gilblankenship/CompanionRobotWeaver/images/blankenship.jpg

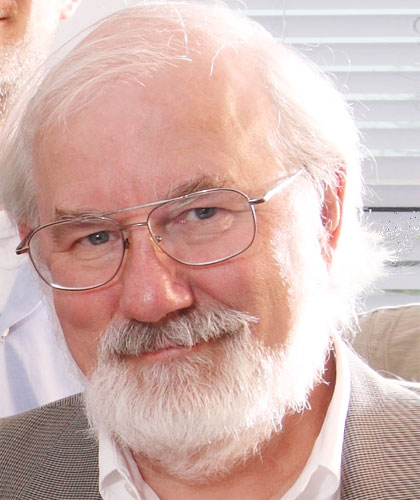
images/blankenship.jpg
