gilblankenship/CompanionRobotWeaver/README.md

Autonomous Robotic Companion

To run first call ./ngrok http 5000
then update alexa endpoint to new URL
run python3 main.py

If you force quit main killall python3 processes
