gilblankenship/CompanionRobotWeaver/Confusion Matrix.png

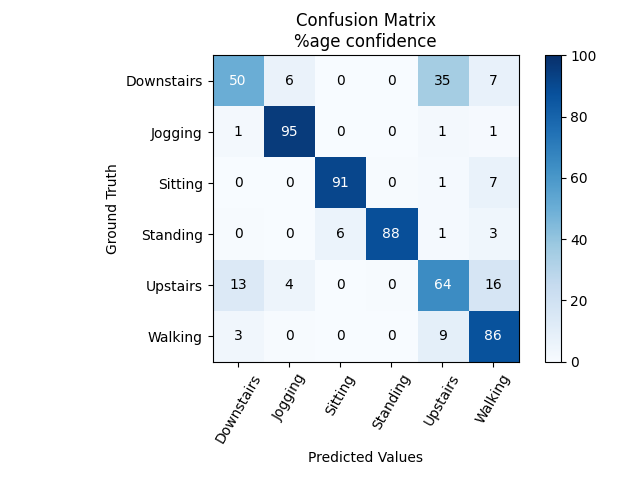
Confusion Matrix.png
