gilblankenship/CompanionRobotWeaver/image.jpg

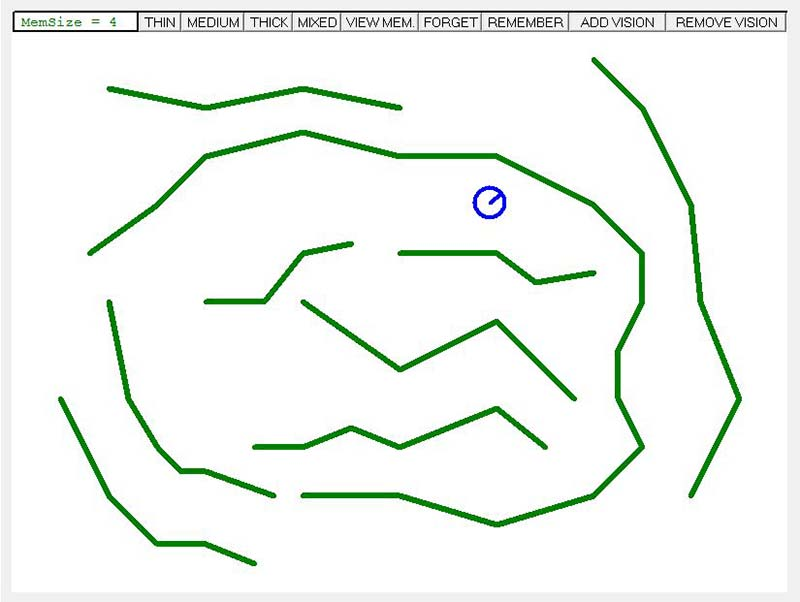
image.jpg
