gilblankenship/CompanionRobotWeaver/images/biden.jpg

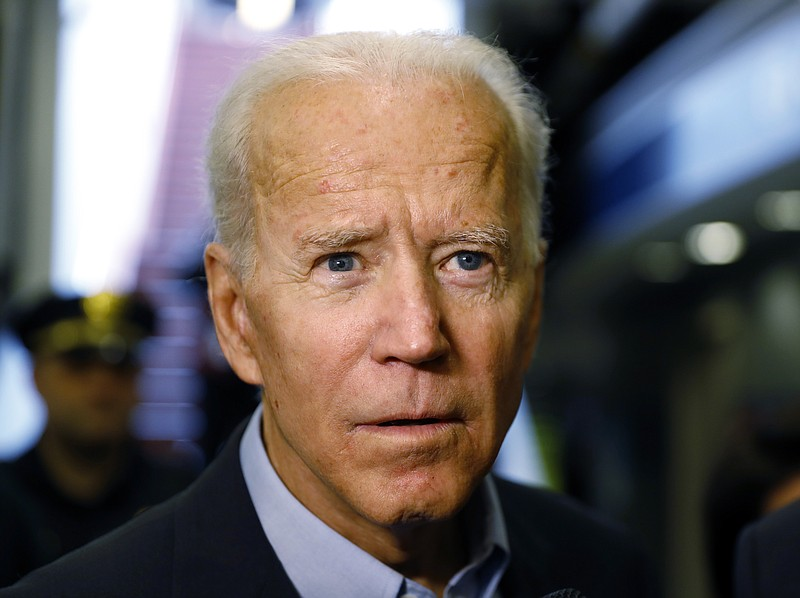
images/biden.jpg
