gilblankenship/CompanionRobotWeaver/images/hizoune.jpg

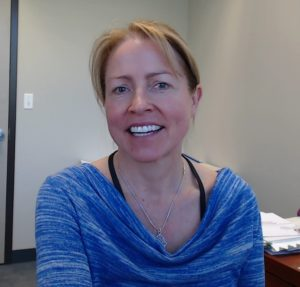
images/hizoune.jpg
