gilblankenship/CompanionRobotWeaver/images/rmacko.jpg

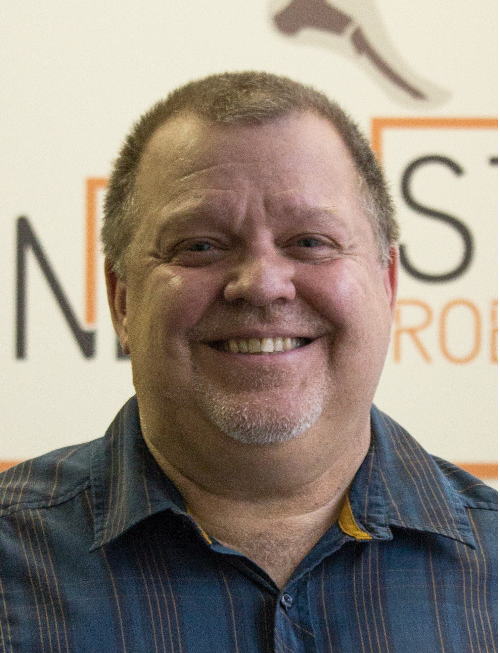
images/rmacko.jpg
