gilblankenship/CompanionRobotWeaver/ardControlerV2/SerialDataComm.ino

/*
Based on  http://www.arduino.cc/en/Tutorial/SerialCallResponseASCII
*/

int firstSensor = 0;    // first analog sensor
int secondSensor = 0;   // second analog sensor
int thirdSensor = 0;    // digital sensor
int inByte = 0;         // incoming serial byte
long randNumber;

void setup() {
  randomSeed(analogRead(0)); // Generate a random seed
  // start serial port at 9600 bps and wait for port to open:
  Serial.begin(9600);
  while (!Serial) {
    ; // wait for serial port to connect. Needed for native USB port only
  }

  pinMode(2, INPUT);   // digital sensor is on digital pin 2
  establishContact();  // send a byte to establish contact until receiver responds
}

void loop() {
  // if we get a valid byte, read analog ins:
  if (Serial.available() > 0) {
    // get incoming byte:
    inByte = Serial.read();
    // read first analog input:
    firstSensor =  random(300); //analogRead(A0);
    // read second analog input:
    randNumber=random(300);
    secondSensor =  randNumber; //analogRead(A1);
    // read switch, map it to 0 or 255
    thirdSensor = map(digitalRead(2), 0, 1, 0, 255);
    // send sensor values:
    Serial.println(firstSensor);
    Serial.print(",");
    Serial.print(secondSensor);
    Serial.print(",");
    Serial.println(thirdSensor);
  }
}

void establishContact() {
  while (Serial.available() <= 0) {
    Serial.println("0,0,0");   // send an initial string
    delay(300);
  }
}
