gilblankenship/CompanionRobotWeaver/AutoregressiveTransformerModel.py

import tensorflow as tf

class AutoregressiveTransformerModel(tf.keras.Model):
    def __init__(self, vocab_size, embedding_dim, hidden_dim, num_heads, key_dim):
        super(AutoregressiveTransformerModel, self).__init__()
        self.embedding = tf.keras.layers.Embedding(vocab_size, embedding_dim)
        self.attention = tf.keras.layers.MultiHeadAttention(num_heads=num_heads, 
                                                            key_dim=key_dim)
        self.dense = tf.keras.layers.Dense(vocab_size)

    def call(self, inputs):
        x = self.embedding(inputs)
        x = self.attention(x, x, x)
        x = self.dense(x)
        return x
import tensorflow as tf

def main():
    # Create the model
    vocab_size = 10000
    embedding_dim = 128
    hidden_dim = 256
    num_heads = 8
    key_dim=10
    model = AutoregressiveTransformerModel(vocab_size, embedding_dim, hidden_dim, num_heads, key_dim)

    # Load the model weights
    model.load_weights("model.h5")

    # Generate text
    start_token = tf.constant([1])
    generated_text = tf.zeros([1, 100])
    for _ in range(100):
        next_token_predictions = model(generated_text)
        next_token = tf.argmax(next_token_predictions, axis=-1)
        generated_text = tf.concat([generated_text, next_token], axis=-1)

    print(generated_text)

if __name__ == "__main__":
    main()
