gilblankenship/CompanionRobotWeaver/SearchRegionXavier.py

```python
import cv2
import numpy as np
import math
import time
import csv
import serial

# initialize the camera
cap = cv2.VideoCapture(0)

# initialize the facial recognition model
face_cascade = cv2.CascadeClassifier('haarcascade_frontalface_default.xml')

# initialize the GPS
gps = gps.GPS()

# initialize the two driven wheels
left_wheel = Motor(17)
right_wheel = Motor(27)

# set the speed of the two driven wheels
left_wheel.set_speed(50)
right_wheel.set_speed(50)

# start the loop
while True:

    # get a frame from the camera
    ret, frame = cap.read()

    # convert the frame to grayscale
    gray = cv2.cvtColor(frame, cv2.COLOR_BGR2GRAY)

    # find the faces in the frame
    faces = face_cascade.detectMultiScale(gray, 1.3, 5)

    # for each face in the frame
    for (x, y, w, h) in faces:

        # draw a rectangle around the face
        cv2.rectangle(frame, (x, y), (x + w, y + h), (0, 255, 0), 2)

        # crop the face out of the frame
        face_roi = frame[y:y + h, x:x + w]

        # recognize the face
        face_id = recognize_face(face_roi)

        # if the face is recognized
        if face_id is not None:

            # print the name of the person
            print('The person in the frame is {}'.format(face_id))

            # get the location of the person
            (lat, lon) = gps.get_location()

            # print the location of the person
            print('The person is at {} {}'.format(lat, lon))

            # stop the robot
            left_wheel.stop()
            right_wheel.stop()

            # break out of the loop
            break

    # show the frame
    cv2.imshow('Frame', frame)

    # wait for a key press
    key = cv2.waitKey(1)

    # if the key is 'q', quit the program
    if key == ord('q'):
        break

# release the camera
cap.release()

# close all windows
cv2.destroyAllWindows()
```

**Code for the `recognize_face()` function:**

```python
def recognize_face(face_roi):

    # load the face recognition model
    model = cv2.face.LBPHFaceRecognizer_create()

    # load the face embeddings
    with open('faces.csv', 'r') as csvfile:
        reader = csv.reader(csvfile)
        for row in reader:
            face_id, face_embedding = row
            model.train([face_embedding])

    # get the face embedding
    face_embedding = get_face_embedding(face_roi)

    # recognize the face
    face_id = model.predict(face_embedding)

    # return the face id
    return face_id
```

**Code for the `get_face_embedding()` function:**

```python
def get_face_embedding(face_roi):

    # convert the face roi to a numpy array
    face_roi = np.array(face_roi)

    # pre-process the face roi
    face_roi = cv2.resize(face_roi, (160, 160))
    face_roi = cv2.cvtColor(face_roi, cv2.COLOR_BGR2RGB)
    face_roi = face_roi.astype('float32')
    face_roi /= 255.0

    # get the face embedding
    face_embedding = face_recognition.face_encodings(face_roi)[0]

    # return
