gilblankenship/CompanionRobotWeaver/MAML Example.py

import torch
import torch.nn as nn
import torch.optim as optim

# Define the model
class MAML(nn.Module):
  def __init__(self):
    super(MAML, self).__init__()
    self.linear1 = nn.Linear(10, 10)
    self.linear2 = nn.Linear(10, 10)

  def forward(self, x):
    x = torch.relu(self.linear1(x))
    x = self.linear2(x)
    return x

# Create the model
model = MAML()

# Define the optimizer
optimizer = optim.SGD(model.parameters(), lr=0.01)

# Initialize the task parameters
task_parameters = torch.randn(10)

# Initialize the accuracy
accuracy = 0

# Train the model
for i in range(100):
  # Sample a task
  task_data = torch.randn(10)

  # Update the task parameters
  updated_task_parameters = model(task_data)

  # Calculate the loss
  loss = torch.nn.functional.mse_loss(updated_task_parameters, task_data)

  # Backpropagate the loss
  optimizer.zero_grad()
  loss.backward()
  optimizer.step()

  # Calculate the accuracy
  predictions = model(task_data)
  accuracy = accuracy + torch.mean((predictions - task_data).pow(2))

# Evaluate the model
test_data = torch.randn(10)
predictions = model(test_data)

# Calculate the accuracy
accuracy = accuracy / 100

print(accuracy)
