gilblankenship/CompanionRobotWeaver/(commit log)

2020-10-16 Moved Arduino files to the same directory Modified the xTaskCreate commands to remove portChar declaration compile error
    [MotorControl.h, Ultrasound.cpp, Ultrasound.h, ardControlerV2.ino]
2020-10-16 Moved Arduino files to the same directory Modified the xTaskCreate commands to remove portChar declaration compile error.
    [ardControlerV2.ino]
2020-10-17 Moved Arduino files to the same directory Modified the xTaskCreate commands to remove portChar declaration compile error. 2020-10-17: Some minor edits in Arduino code.
    [Ultrasound.cpp, ardControlerV2.ino]
2020-10-26 Moved Arduino files to the same directory Modified the xTaskCreate commands to remove portChar declaration compile error. 2020-10-17: Some minor edits in Arduino code. 2020-10-17: Minor edits to main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
    [ardControlerV2.ino, constants.py, main.py, openCVController.py]
2023-08-11 Track line
